coloradocube/eps/eps-eda/eps_bom/eps_BOM.xlsx

Sheet: eps_masterBOM
; | /Users/sethschisler/eps/eps-eda/master_schematic.kicad_sch
Date: | Monday, April 25, 2022 at 09:28:04 AM
Tool: | Eeschema (6.0.1-0)
Generator: | /Applications/KiCad/KiCad.app/Contents/SharedSupport/plugins/bom_csv_grouped_by_value_with_fp.py |  |  |  |  | DOES JLC CARRY? Y/N | Parts list: https://jlcpcb.com/parts/componentSearch
Component Count: | 80
Ref | Qnty | Value | Cmp name | Footprint | Description
C1, C2, C8, C10, C11, C12, | 6 | 10uF | C_Small | Capacitor_SMD:C_0603_1608Metric | Unpolarized capacitor, small symbol | Y
C3, | 1 | 0.1ŒºF | C_Small | Capacitor_SMD:C_0402_1005Metric | Unpolarized capacitor, small symbol | Y
C5, C6, C7, | 3 | 2.2uF | C_Small | Capacitor_SMD:C_0603_1608Metric | Unpolarized capacitor, small symbol | Y
C9, | 1 | 0.1uF | C_Small | Capacitor_SMD:C_0402_1005Metric | Unpolarized capacitor, small symbol | Y
C13, C20, | 2 | 22uF | C | Capacitor_SMD:C_0603_1608Metric | Unpolarized capacitor | Y
C14, C18, C19, C21, | 4 | 0.1uF | C | Capacitor_SMD:C_0603_1608Metric | Unpolarized capacitor | Y
C15, | 1 | 0.47uF | C_Small | Capacitor_SMD:C_0603_1608Metric | Unpolarized capacitor, small symbol | Y
C16, | 1 | 100nF | C | Capacitor_SMD:C_0603_1608Metric | Unpolarized capacitor | Y
C17, | 1 | 4.7nF | C | Capacitor_SMD:C_0603_1608Metric | Unpolarized capacitor | Y
Ca1, Ca2, Ca3, | 3 | 22uF | C2012X5R1A226M125AB | Capacitor_SMD:C_0805_2012Metric | Unpolarized capacitor, small symbol | Y
Cb1, Cb2, Cb3, | 3 | 22uF | C2012X5R1A226M125AB | Capacitor_SMD:C_0805_2012Metric | Unpolarized capacitor, small symbol | Y
D1, D2, | 2 | LED | LED | LED_SMD:LED_0603_1608Metric | Light emitting diode
D4, | 1 | PD3Z284C3V6-7 | PD3Z284C3V6-7 | zener_ovp:PD3Z284C3V6-7 |  | N
D5, | 1 | RED | LED_Small_Filled | LED_SMD:LED_0603_1608Metric | Light emitting diode, small symbol, filled shape
D6, | 1 | GREEN | LED_Small_Filled | LED_SMD:LED_0603_1608Metric | Light emitting diode, small symbol, filled shape
D7, D8, D9, | 3 | YELLOW | LED_Small_Filled | LED_SMD:LED_0603_1608Metric | Light emitting diode, small symbol, filled shape
D_3.3, | 1 | PD3S230LQ-7 | PD3S230LQ-7 | footprints3:PD3S230LQ-7 |  | N
Din1, | 1 | DIODE | DIODE | Diode_SMD:D_0805_2012Metric | Diode, anode on pin 1, for simulation only! | <---do we need this??
J1, | 1 | 12401610E4#2A | USB_C_Receptacle | Connector_USB:USB_C_Receptacle_Amphenol_12401610E4-2A | USB Full-Featured Type-C Receptacle connector | N
J2, | 1 | 436500212 | 436500212 | molex connector:436500212 |  | Y
J3, | 1 | 826632-2 | Conn_02x20_Odd_Even | Connector_PinHeader_2.54mm:PinHeader_2x20_P2.54mm_Vertical | Generic connector, double row, 02x20, odd/even pin numbering scheme (row 1 odd numbers, row 2 even numbers), script generated (kicad-library-utils/schlib/autogen/connector/) | N
J4, | 1 | PH1RB-05-UA | Conn_01x05_Female | Connector_PinHeader_2.54mm:PinHeader_1x05_P2.54mm_Horizontal | Generic connector, single row, 01x05, script generated (kicad-library-utils/schlib/autogen/connector/) | N
JP1, | 1 | SolderJumper_2_Open | SolderJumper_2_Open | Jumper:SolderJumper-2_P1.3mm_Bridged2Bar_Pad1.0x1.5mm | Solder Jumper, 2-pole, open | <---do we need this??
L1, | 1 | .47uH | CIGT252010LMR47MNE | Inductor_SMD:L_1008_2520Metric | Inductor, small symbol | N
L2, L3, | 2 | 744316100 | 744316100 | footprints1:744316100 |  | N
Q2, | 1 | FZT688BTA | 2N2219 | fzt688bta_footprint:SOT230P700X180-4N | 800mA Ic, 50V Vce, NPN Transistor, TO-39 | out of stock
R1, R2, | 2 | PSF4NTEBL500F | PSF4NTEBL500F | psf4nt:PSF4NTEBL500F |  | Y
R3, R4, R5, R6, R7, | 5 | 10kŒ© | R_Small_US | Resistor_SMD:R_0603_1608Metric | Resistor, small US symbol | Y
R8, R10, | 2 | 1k | R_Small_US | Resistor_SMD:R_0402_1005Metric | Resistor, small US symbol | Y
R9, | 1 | 24.9k | R_Small_US | Resistor_SMD:R_0402_1005Metric | Resistor, small US symbol | Y
R11, | 1 | 10k | R_Small_US | Resistor_SMD:R_0402_1005Metric | Resistor, small US symbol | Y
R12, | 1 | 0.01 | R_Small_US | Resistor_SMD:R_0805_2012Metric | Resistor, small US symbol
R13, R14, | 2 | 60 | R | Resistor_SMD:R_0603_1608Metric | Resistor | Y
R15, | 1 | 10k | R | Resistor_SMD:R_0603_1608Metric | Resistor | Y
R16, | 1 | 200 | R | Resistor_SMD:R_0603_1608Metric | Resistor | Y
R19, R20, R21, R22, R23, | 5 | 330 | R | Resistor_SMD:R_0603_1608Metric | Resistor | Y
R_3.3, | 1 | 1k | R_Small_US | Resistor_SMD:R_0603_1608Metric | Resistor, small US symbol | Y
Ra1, | 1 | 732K | RMCF0603FG732K | Resistor_SMD:R_0603_1608Metric | Resistor, small US symbol | N
Ra2, | 1 | 100k | KTR03EZPF1003 | Resistor_SMD:R_0603_1608Metric | Resistor, small US symbol | Y
Rb1, | 1 | 453k | RMCF0603FT453K | Resistor_SMD:R_0603_1608Metric | Resistor, small US symbol | N
Rb2, | 1 | 100k | KTR03EZPF1003 | Resistor_SMD:R_0603_1608Metric | Resistor, small US symbol | Y
Rpu1, | 1 | 10kŒ© | R_Small_US | Resistor_SMD:R_0603_1608Metric | Resistor, small US symbol | Y
TH1, | 1 | 10k | NTCS0603E3103HLT | Resistor_SMD:R_0603_1608Metric | Temperature dependent resistor, negative temperature coefficient | N
U1, U2, | 2 | TPS61022RWUR | TPS61022RWUR | footprints:TPS61022RWUR |  | N
U3, | 1 | INA3221AIRGVR | INA3221 | Package_DFN_QFN:Texas_RGV_S-PVQFN-N16_EP2.1x2.1mm | Triple-Channel High-Side Shunt and Bus Voltage Monitor with I2C and SMBUS Compatible Interface, QFN-16 | Y
U5, | 1 | MAX77757JEFG435+ | MAX77757JEFG435+ | max77757:IC_MAX77757JEFG435+ |  | N
U6, | 1 | MAX17055ETB+T | MAX17055ETB+T | max17055 smd:MAX17055ETB&plus_T |  | N
U7, | 1 | ATA6560-GAQW-VAO | ATA6560-GAQW-VAO | ata6560:ATA6560-GAQW-VAO |  | N
U8, | 1 | PIC18F27Q84-E/SP | PIC18F27Q84-E{slash}SP | pic18f27:PIC18F27Q84-E&slash_SP |  | N

Sheet: eps_masterBOM (2)
; | /Users/sethschisler/eps/eps-eda/master_schematic.kicad_sch
Date: | Monday, April 25, 2022 at 09:28:04 AM
Tool: | Eeschema (6.0.1-0)
Generator: | /Applications/KiCad/KiCad.app/Contents/SharedSupport/plugins/bom_csv_grouped_by_value_with_fp.py |  |  |  |  | DOES JLC CARRY? Y/N | Parts list: https://jlcpcb.com/parts/componentSearch
Component Count: | 80
Ref | Qnty | Value | Cmp name | Footprint | Description |  | Comment | Designator | Footprint | JLSPCB Part #
C1, C2, C8, C10, C11, C12, | 6 | 10uF | C_Small | Capacitor_SMD:C_0603_1608Metric | Unpolarized capacitor, small symbol | Y | 10uF, C_Small, Unpolarized capacitor, small symbol | C1, C2, C8, C10, C11, C12, | Capacitor_SMD:C_0603_1608Metric
C3, | 1 | 0.1uF | C_Small | Capacitor_SMD:C_0402_1005Metric | Unpolarized capacitor, small symbol | Y | 0.1uF, C_Small, Unpolarized capacitor, small symbol | C3, | Capacitor_SMD:C_0402_1005Metric
C5, C6, C7, | 3 | 2.2uF | C_Small | Capacitor_SMD:C_0603_1608Metric | Unpolarized capacitor, small symbol | Y | 2.2uF, C_Small, Unpolarized capacitor, small symbol | C5, C6, C7, | Capacitor_SMD:C_0603_1608Metric
C9, | 1 | 0.1uF | C_Small | Capacitor_SMD:C_0402_1005Metric | Unpolarized capacitor, small symbol | Y | 0.1uF, C_Small, Unpolarized capacitor, small symbol | C9, | Capacitor_SMD:C_0402_1005Metric
C13, C20, | 2 | 22uF | C | Capacitor_SMD:C_0603_1608Metric | Unpolarized capacitor | Y | 22uF, C, Unpolarized capacitor | C13, C20, | Capacitor_SMD:C_0603_1608Metric
C14, C18, C19, C21, | 4 | 0.1uF | C | Capacitor_SMD:C_0603_1608Metric | Unpolarized capacitor | Y | 0.1uF, C, Unpolarized capacitor | C14, C18, C19, C21, | Capacitor_SMD:C_0603_1608Metric
C15, | 1 | 0.47uF | C_Small | Capacitor_SMD:C_0603_1608Metric | Unpolarized capacitor, small symbol | Y | 0.47uF, C_Small, Unpolarized capacitor, small symbol | C15, | Capacitor_SMD:C_0603_1608Metric
C16, | 1 | 100nF | C | Capacitor_SMD:C_0603_1608Metric | Unpolarized capacitor | Y | 100nF, C, Unpolarized capacitor | C16, | Capacitor_SMD:C_0603_1608Metric
C17, | 1 | 4.7nF | C | Capacitor_SMD:C_0603_1608Metric | Unpolarized capacitor | Y | 4.7nF, C, Unpolarized capacitor | C17, | Capacitor_SMD:C_0603_1608Metric
Ca1, Ca2, Ca3, | 3 | 22uF | C2012X5R1A226M125AB | Capacitor_SMD:C_0805_2012Metric | Unpolarized capacitor, small symbol | Y | 22uF, C2012X5R1A226M125AB, Unpolarized capacitor, small symbol | Ca1, Ca2, Ca3, | Capacitor_SMD:C_0805_2012Metric
Cb1, Cb2, Cb3, | 3 | 22uF | C2012X5R1A226M125AB | Capacitor_SMD:C_0805_2012Metric | Unpolarized capacitor, small symbol | Y | 22uF, C2012X5R1A226M125AB, Unpolarized capacitor, small symbol | Cb1, Cb2, Cb3, | Capacitor_SMD:C_0805_2012Metric
D1, D2, | 2 | LED | LED | LED_SMD:LED_0603_1608Metric | Light emitting diode |  | LED, LED, Light emitting diode | D1, D2, | LED_SMD:LED_0603_1608Metric
D4, | 1 | PD3Z284C3V6-7 | PD3Z284C3V6-7 | zener_ovp:PD3Z284C3V6-7 |  | N | PD3Z284C3V6-7, PD3Z284C3V6-7, | D4, | zener_ovp:PD3Z284C3V6-7
D5, | 1 | RED | LED_Small_Filled | LED_SMD:LED_0603_1608Metric | Light emitting diode, small symbol, filled shape |  | RED, LED_Small_Filled, Light emitting diode, small symbol, filled shape | D5, | LED_SMD:LED_0603_1608Metric
D6, | 1 | GREEN | LED_Small_Filled | LED_SMD:LED_0603_1608Metric | Light emitting diode, small symbol, filled shape |  | GREEN, LED_Small_Filled, Light emitting diode, small symbol, filled shape | D6, | LED_SMD:LED_0603_1608Metric
D7, D8, D9, | 3 | YELLOW | LED_Small_Filled | LED_SMD:LED_0603_1608Metric | Light emitting diode, small symbol, filled shape |  | YELLOW, LED_Small_Filled, Light emitting diode, small symbol, filled shape | D7, D8, D9, | LED_SMD:LED_0603_1608Metric
D_3.3, | 1 | PD3S230LQ-7 | PD3S230LQ-7 | footprints3:PD3S230LQ-7 |  | N | PD3S230LQ-7, PD3S230LQ-7, | D_3.3, | footprints3:PD3S230LQ-7
Din1, | 1 | DIODE | DIODE | Diode_SMD:D_0805_2012Metric | Diode, anode on pin 1, for simulation only! | <---do we need this?? | DIODE, DIODE, Diode, anode on pin 1, for simulation only! | Din1, | Diode_SMD:D_0805_2012Metric
J1, | 1 | 12401610E4#2A | USB_C_Receptacle | Connector_USB:USB_C_Receptacle_Amphenol_12401610E4-2A | USB Full-Featured Type-C Receptacle connector | N | 12401610E4#2A, USB_C_Receptacle, USB Full-Featured Type-C Receptacle connector | J1, | Connector_USB:USB_C_Receptacle_Amphenol_12401610E4-2A
J2, | 1 | 436500212 | 436500212 | molex connector:436500212 |  | Y | 436500212, 436500212, | J2, | molex connector:436500212
J3, | 1 | 826632-2 | Conn_02x20_Odd_Even | Connector_PinHeader_2.54mm:PinHeader_2x20_P2.54mm_Vertical | Generic connector, double row, 02x20, odd/even pin numbering scheme (row 1 odd numbers, row 2 even numbers), script generated (kicad-library-utils/schlib/autogen/connector/) | N | 826632-2, Conn_02x20_Odd_Even, Generic connector, double row, 02x20, odd/even pin numbering scheme (row 1 odd numbers, row 2 even numbers), script generated (kicad-library-utils/schlib/autogen/connector/) | J3, | Connector_PinHeader_2.54mm:PinHeader_2x20_P2.54mm_Vertical
J4, | 1 | PH1RB-05-UA | Conn_01x05_Female | Connector_PinHeader_2.54mm:PinHeader_1x05_P2.54mm_Horizontal | Generic connector, single row, 01x05, script generated (kicad-library-utils/schlib/autogen/connector/) | N | PH1RB-05-UA, Conn_01x05_Female, Generic connector, single row, 01x05, script generated (kicad-library-utils/schlib/autogen/connector/) | J4, | Connector_PinHeader_2.54mm:PinHeader_1x05_P2.54mm_Horizontal
JP1, | 1 | SolderJumper_2_Open | SolderJumper_2_Open | Jumper:SolderJumper-2_P1.3mm_Bridged2Bar_Pad1.0x1.5mm | Solder Jumper, 2-pole, open | <---do we need this?? | SolderJumper_2_Open, SolderJumper_2_Open, Solder Jumper, 2-pole, open | JP1, | Jumper:SolderJumper-2_P1.3mm_Bridged2Bar_Pad1.0x1.5mm
L1, | 1 | .47uH | CIGT252010LMR47MNE | Inductor_SMD:L_1008_2520Metric | Inductor, small symbol | N | .47uH, CIGT252010LMR47MNE, Inductor, small symbol | L1, | Inductor_SMD:L_1008_2520Metric
L2, L3, | 2 | 744316100 | 744316100 | footprints1:744316100 |  | N | 744316100, 744316100, | L2, L3, | footprints1:744316100
Q2, | 1 | FZT688BTA | 2N2219 | fzt688bta_footprint:SOT230P700X180-4N | 800mA Ic, 50V Vce, NPN Transistor, TO-39 | out of stock | FZT688BTA, 2N2219, 800mA Ic, 50V Vce, NPN Transistor, TO-39 | Q2, | fzt688bta_footprint:SOT230P700X180-4N
R1, R2, | 2 | PSF4NTEBL500F | PSF4NTEBL500F | psf4nt:PSF4NTEBL500F |  | Y | PSF4NTEBL500F, PSF4NTEBL500F, | R1, R2, | psf4nt:PSF4NTEBL500F
R3, R4, R5, R6, R7, | 5 | 10k | R_Small_US | Resistor_SMD:R_0603_1608Metric | Resistor, small US symbol | Y | 10k, R_Small_US, Resistor, small US symbol | R3, R4, R5, R6, R7, | Resistor_SMD:R_0603_1608Metric
R8, R10, | 2 | 1k | R_Small_US | Resistor_SMD:R_0402_1005Metric | Resistor, small US symbol | Y | 1k, R_Small_US, Resistor, small US symbol | R8, R10, | Resistor_SMD:R_0402_1005Metric
R9, | 1 | 24.9k | R_Small_US | Resistor_SMD:R_0402_1005Metric | Resistor, small US symbol | Y | 24.9k, R_Small_US, Resistor, small US symbol | R9, | Resistor_SMD:R_0402_1005Metric
R11, | 1 | 10k | R_Small_US | Resistor_SMD:R_0402_1005Metric | Resistor, small US symbol | Y | 10k, R_Small_US, Resistor, small US symbol | R11, | Resistor_SMD:R_0402_1005Metric
R12, | 1 | 0.01 | R_Small_US | Resistor_SMD:R_0805_2012Metric | Resistor, small US symbol |  | 0.01, R_Small_US, Resistor, small US symbol | R12, | Resistor_SMD:R_0805_2012Metric
R13, R14, | 2 | 60 | R | Resistor_SMD:R_0603_1608Metric | Resistor | Y | 60, R, Resistor | R13, R14, | Resistor_SMD:R_0603_1608Metric
R15, | 1 | 10k | R | Resistor_SMD:R_0603_1608Metric | Resistor | Y | 10k, R, Resistor | R15, | Resistor_SMD:R_0603_1608Metric
R16, | 1 | 200 | R | Resistor_SMD:R_0603_1608Metric | Resistor | Y | 200, R, Resistor | R16, | Resistor_SMD:R_0603_1608Metric
R19, R20, R21, R22, R23, | 5 | 330 | R | Resistor_SMD:R_0603_1608Metric | Resistor | Y | 330, R, Resistor | R19, R20, R21, R22, R23, | Resistor_SMD:R_0603_1608Metric
R_3.3, | 1 | 1k | R_Small_US | Resistor_SMD:R_0603_1608Metric | Resistor, small US symbol | Y | 1k, R_Small_US, Resistor, small US symbol | R_3.3, | Resistor_SMD:R_0603_1608Metric
Ra1, | 1 | 732K | RMCF0603FG732K | Resistor_SMD:R_0603_1608Metric | Resistor, small US symbol | N | 732K, RMCF0603FG732K, Resistor, small US symbol | Ra1, | Resistor_SMD:R_0603_1608Metric
Ra2, | 1 | 100k | KTR03EZPF1003 | Resistor_SMD:R_0603_1608Metric | Resistor, small US symbol | Y | 100k, KTR03EZPF1003, Resistor, small US symbol | Ra2, | Resistor_SMD:R_0603_1608Metric
Rb1, | 1 | 453k | RMCF0603FT453K | Resistor_SMD:R_0603_1608Metric | Resistor, small US symbol | N | 453k, RMCF0603FT453K, Resistor, small US symbol | Rb1, | Resistor_SMD:R_0603_1608Metric
Rb2, | 1 | 100k | KTR03EZPF1003 | Resistor_SMD:R_0603_1608Metric | Resistor, small US symbol | Y | 100k, KTR03EZPF1003, Resistor, small US symbol | Rb2, | Resistor_SMD:R_0603_1608Metric
Rpu1, | 1 | 10k | R_Small_US | Resistor_SMD:R_0603_1608Metric | Resistor, small US symbol | Y | 10k, R_Small_US, Resistor, small US symbol | Rpu1, | Resistor_SMD:R_0603_1608Metric
TH1, | 1 | 10k | NTCS0603E3103HLT | Resistor_SMD:R_0603_1608Metric | Temperature dependent resistor, negative temperature coefficient | N | 10k, NTCS0603E3103HLT, Temperature dependent resistor, negative temperature coefficient | TH1, | Resistor_SMD:R_0603_1608Metric
U1, U2, | 2 | TPS61022RWUR | TPS61022RWUR | footprints:TPS61022RWUR |  | N | TPS61022RWUR, TPS61022RWUR, | U1, U2, | footprints:TPS61022RWUR
U3, | 1 | INA3221AIRGVR | INA3221 | Package_DFN_QFN:Texas_RGV_S-PVQFN-N16_EP2.1x2.1mm | Triple-Channel High-Side Shunt and Bus Voltage Monitor with I2C and SMBUS Compatible Interface, QFN-16 | Y | INA3221AIRGVR, INA3221, Triple-Channel High-Side Shunt and Bus Voltage Monitor with I2C and SMBUS Compatible Interface, QFN-16 | U3, | Package_DFN_QFN:Texas_RGV_S-PVQFN-N16_EP2.1x2.1mm
U5, | 1 | MAX77757JEFG435+ | MAX77757JEFG435+ | max77757:IC_MAX77757JEFG435+ |  | N | MAX77757JEFG435+, MAX77757JEFG435+, | U5, | max77757:IC_MAX77757JEFG435+
U6, | 1 | MAX17055ETB+T | MAX17055ETB+T | max17055 smd:MAX17055ETB&plus_T |  | N | MAX17055ETB+T, MAX17055ETB+T, | U6, | max17055 smd:MAX17055ETB&plus_T
U7, | 1 | ATA6560-GAQW-VAO | ATA6560-GAQW-VAO | ata6560:ATA6560-GAQW-VAO |  | N | ATA6560-GAQW-VAO, ATA6560-GAQW-VAO, | U7, | ata6560:ATA6560-GAQW-VAO
U8, | 1 | PIC18F27Q84-E/SP | PIC18F27Q84-E{slash}SP | pic18f27:PIC18F27Q84-E&slash_SP |  | N | PIC18F27Q84-E/SP, PIC18F27Q84-E{slash}SP, | U8, | pic18f27:PIC18F27Q84-E&slash_SP

Sheet: eps_BOM_JLCPCB_220513
Comment | Designator | Footprint | JLSPCB Part # | Notes
10uF, C_Small, Unpolarized capacitor, small symbol | C1, C2, C8, C10, C11, C12, | Capacitor_SMD:C_0603_1608Metric | C19702
0.1uF, C_Small, Unpolarized capacitor, small symbol | C3, | Capacitor_SMD:C_0402_1005Metric | C1525
2.2uF, C_Small, Unpolarized capacitor, small symbol | C5, C6, C7, | Capacitor_SMD:C_0603_1608Metric | C23630
0.1uF, C_Small, Unpolarized capacitor, small symbol | C9, | Capacitor_SMD:C_0402_1005Metric | C1525
22uF, C, Unpolarized capacitor | C13, C20, | Capacitor_SMD:C_0603_1608Metric | C59461
0.1uF, C, Unpolarized capacitor | C14, C18, C19, C21, | Capacitor_SMD:C_0603_1608Metric | C14663
0.47uF, C_Small, Unpolarized capacitor, small symbol | C15, | Capacitor_SMD:C_0603_1608Metric | C1623
100nF, C, Unpolarized capacitor | C16, | Capacitor_SMD:C_0603_1608Metric | C14663
4.7nF, C, Unpolarized capacitor | C17, | Capacitor_SMD:C_0603_1608Metric | C53987
22uF, C2012X5R1A226M125AB, Unpolarized capacitor, small symbol | Ca1, Ca2, Ca3, | Capacitor_SMD:C_0805_2012Metric |  | Order | Mouser | https://www.mouser.com/ProductDetail/TDK/C2012X5R1A226M125AB?qs=LcTL%2F5vFEzEl81ah%2FUQuuw%3D%3D
22uF, C2012X5R1A226M125AB, Unpolarized capacitor, small symbol | Cb1, Cb2, Cb3, | Capacitor_SMD:C_0805_2012Metric |  | Order | Mouser | https://www.mouser.com/ProductDetail/TDK/C2012X5R1A226M125AB?qs=LcTL%2F5vFEzEl81ah%2FUQuuw%3D%3D
LED, LED, Light emitting diode | D1, D2, | LED_SMD:LED_0603_1608Metric | C2286
PD3Z284C3V6-7, PD3Z284C3V6-7, | D4, | zener_ovp:PD3Z284C3V6-7 |  | Order | DigiKey | https://www.digikey.com/en/products/detail/diodes-incorporated/PD3Z284C3V6-7/1629585
RED, LED_Small_Filled, Light emitting diode, small symbol, filled shape | D5, | LED_SMD:LED_0603_1608Metric | C2286
GREEN, LED_Small_Filled, Light emitting diode, small symbol, filled shape | D6, | LED_SMD:LED_0603_1608Metric | C72043
YELLOW, LED_Small_Filled, Light emitting diode, small symbol, filled shape | D7, D8, D9, | LED_SMD:LED_0603_1608Metric | C72038
PD3S230LQ-7, PD3S230LQ-7, | D_3.3, | footprints3:PD3S230LQ-7 |  | Order | Mouser | https://www.mouser.com/ProductDetail/Diodes-Incorporated/PD3S230HQ-7?qs=gAfoL%252BRo%2FrJZ9ppNTG9EUw%3D%3D
DIODE, DIODE, Diode, anode on pin 1, for simulation only! | Din1, | Diode_SMD:D_0805_2012Metric |  | Remove?
12401610E4#2A, USB_C_Receptacle, USB Full-Featured Type-C Receptacle connector | J1, | Connector_USB:USB_C_Receptacle_Amphenol_12401610E4-2A |  | Order | DigiKey | https://www.digikey.com/en/products/detail/amphenol-commercial-products/12401610E4%232A/5775520
436500212, 436500212, | J2, | molex connector:436500212 | C240839
826632-2, Conn_02x20_Odd_Even, Generic connector, double row, 02x20, odd/even pin numbering scheme (row 1 odd numbers, row 2 even numbers), script generated (kicad-library-utils/schlib/autogen/connector/) | J3, | Connector_PinHeader_2.54mm:PinHeader_2x20_P2.54mm_Vertical |  | Order | DigiKey | https://www.digikey.com/en/products/detail/te-connectivity-amp-connectors/826632-2/2276129
PH1RB-05-UA, Conn_01x05_Female, Generic connector, single row, 01x05, script generated (kicad-library-utils/schlib/autogen/connector/) | J4, | Connector_PinHeader_2.54mm:PinHeader_1x05_P2.54mm_Horizontal |  | Order | DigiKey | https://www.digikey.com/en/products/detail/adam-tech/PH1RB-06-UA/9830592
SolderJumper_2_Open, SolderJumper_2_Open, Solder Jumper, 2-pole, open | JP1, | Jumper:SolderJumper-2_P1.3mm_Bridged2Bar_Pad1.0x1.5mm |  | Remove
.47uH, CIGT252010LMR47MNE, Inductor, small symbol | L1, | Inductor_SMD:L_1008_2520Metric |  | Order | DigiKey | https://www.digikey.com/en/products/detail/samsung-electro-mechanics/CIGT252010LMR47MNE/7041266
744316100, 744316100, | L2, L3, | footprints1:744316100 |  | Order | Mouser | https://www.mouser.com/ProductDetail/Wurth-Elektronik/744316100?qs=%252B7BPNfeNhvUGKrgWBoCWwA%3D%3D
FZT688BTA, 2N2219, 800mA Ic, 50V Vce, NPN Transistor, TO-39 | Q2, | fzt688bta_footprint:SOT230P700X180-4N | C460087 | Order | Mouser | https://www.mouser.com/ProductDetail/Diodes-Incorporated/FZT688BTA?qs=Fd5IDHV0WqxCjVtHKYqUuw%3D%3D
PSF4NTEBL500F, PSF4NTEBL500F, | R1, R2, | psf4nt:PSF4NTEBL500F |  | Order | DigiKey | https://www.digikey.com/en/products/detail/koa-speer-electronics-inc/PSF4NTEBL500F/12728476
10k, R_Small_US, Resistor, small US symbol | R3, R4, R5, R6, R7, | Resistor_SMD:R_0603_1608Metric | C25804
1k, R_Small_US, Resistor, small US symbol | R8, R10, | Resistor_SMD:R_0402_1005Metric | C11702
24.9k, R_Small_US, Resistor, small US symbol | R9, | Resistor_SMD:R_0402_1005Metric | C25874
10k, R_Small_US, Resistor, small US symbol | R11, | Resistor_SMD:R_0402_1005Metric | C25744
0.01, R_Small_US, Resistor, small US symbol | R12, | Resistor_SMD:R_0805_2012Metric | C728271 | 0.5W
60, R, Resistor | R13, R14, | Resistor_SMD:R_0603_1608Metric | C166918 | Surprisingly difficult to find
10k, R, Resistor | R15, | Resistor_SMD:R_0603_1608Metric | C25804
200, R, Resistor | R16, | Resistor_SMD:R_0603_1608Metric | C8218
330, R, Resistor | R19, R20, R21, R22, R23, | Resistor_SMD:R_0603_1608Metric | C23138
1k, R_Small_US, Resistor, small US symbol | R_3.3, | Resistor_SMD:R_0603_1608Metric | C22764
732K, RMCF0603FG732K, Resistor, small US symbol | Ra1, | Resistor_SMD:R_0603_1608Metric |  | Order | DigiKey | https://www.digikey.com/en/products/detail/stackpole-electronics-inc/RMCF0603FG732K/1714225
100k, KTR03EZPF1003, Resistor, small US symbol | Ra2, | Resistor_SMD:R_0603_1608Metric | C510119
453k, RMCF0603FT453K, Resistor, small US symbol | Rb1, | Resistor_SMD:R_0603_1608Metric | C2484682 | Order | DigiKey | https://www.digikey.com/en/products/detail/stackpole-electronics-inc/RMCF0603FT453K/1761122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
100k, KTR03EZPF1003, Resistor, small US symbol | Rb2, | Resistor_SMD:R_0603_1608Metric | C510119
10k, R_Small_US, Resistor, small US symbol | Rpu1, | Resistor_SMD:R_0603_1608Metric | C25804
10k, NTCS0603E3103HLT, Temperature dependent resistor, negative temperature coefficient | TH1, | Resistor_SMD:R_0603_1608Metric |  | Order | DigiKey | https://www.digikey.com/en/products/detail/vishay-beyschlag-draloric-bc-components/NTCS0603E3103HLT/2615422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
TPS61022RWUR, TPS61022RWUR, | U1, U2, | footprints:TPS61022RWUR |  | OUT OF STOCK GLOBALLY | Mouser | https://www.mouser.com/ProductDetail/Texas-Instruments/TPS61022RWUR?qs=vLWxofP3U2zlxrk4cD0iFA%3D%3D
INA3221AIRGVR, INA3221, Triple-Channel High-Side Shunt and Bus Voltage Monitor with I2C and SMBUS Compatible Interface, QFN-16 | U3, | Package_DFN_QFN:Texas_RGV_S-PVQFN-N16_EP2.1x2.1mm | C181255
MAX77757JEFG435+, MAX77757JEFG435+, | U5, | max77757:IC_MAX77757JEFG435+ |  | Order | DigiKey | https://www.digikey.com/en/products/detail/analog-devices-inc-maxim-integrated/MAX77757JEFG435/13978783
MAX17055ETB+T, MAX17055ETB+T, | U6, | max17055 smd:MAX17055ETB&plus_T | C402925 | OUT OF STOCK GLOBALLY | DigiKey | https://www.digikey.com/en/products/detail/maxim-integrated/MAX17055ETB-T/7200799
ATA6560-GAQW-VAO, ATA6560-GAQW-VAO, | U7, | ata6560:ATA6560-GAQW-VAO |  | On hand
PIC18F27Q84-E/SP, PIC18F27Q84-E{slash}SP, | U8, | pic18f27:PIC18F27Q84-E&slash_SP |  | On hand
