coloradocube/eps/eps-drawings/PDB_BlockDiagram_Rev-C.pdf

## Signal Power

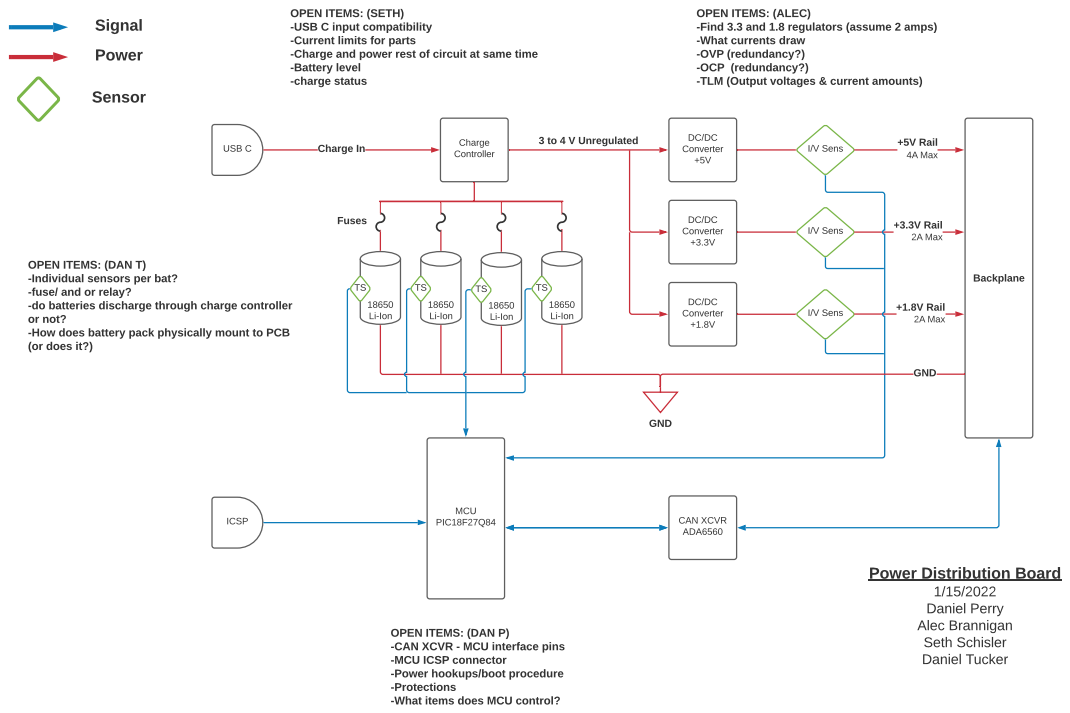
[picture p1: page 1]
Charge Controller; DC/DC Converter +5V; 3 to 4 V Unregulated; Backplane; MCU PIC18F27Q84; I/V Sens; +5V Rail 4A Max; USB C; Charge In; 18650 Li-Ion; CAN XCVR ADA6560; DC/DC Converter +3.3V; DC/DC Converter +1.8V; +3.3V Rail 2A Max; +1.8V Rail 2A Max; GND; Sensor; Fuses; 1/15/2022 Daniel Perry Alec Brannigan Seth Schisler Daniel Tucker; ICSP

OPEN ITEMS: (SETH)
-USB C input compatibility
-Current limits for parts
-Charge and power rest of circuit at same time
-Battery level
-charge status

OPEN ITEMS: (ALEC)
-Find 3.3 and 1.8 regulators (assume 2 amps)
-What currents draw
-OVP (redundancy?)
-OCP (redundancy?)
-TLM (Output voltages & current amounts)

OPEN ITEMS: (DAN T)
-Individual sensors per bat?
-fuse/ and or relay?
-do batteries discharge through charge controller
or not?
-How does battery pack physically mount to PCB
(or does it?)

Power Distribution Board

OPEN ITEMS: (DAN P)
-CAN XCVR - MCU interface pins
-MCU ICSP connector
-Power hookups/boot procedure
-Protections
-What items does MCU control?
