coloradocube/eps/eps-eda/master_schematic.kicad_pcb

## KiCad design eps-eda/master_schematic.kicad_pcb (2022-04-25)

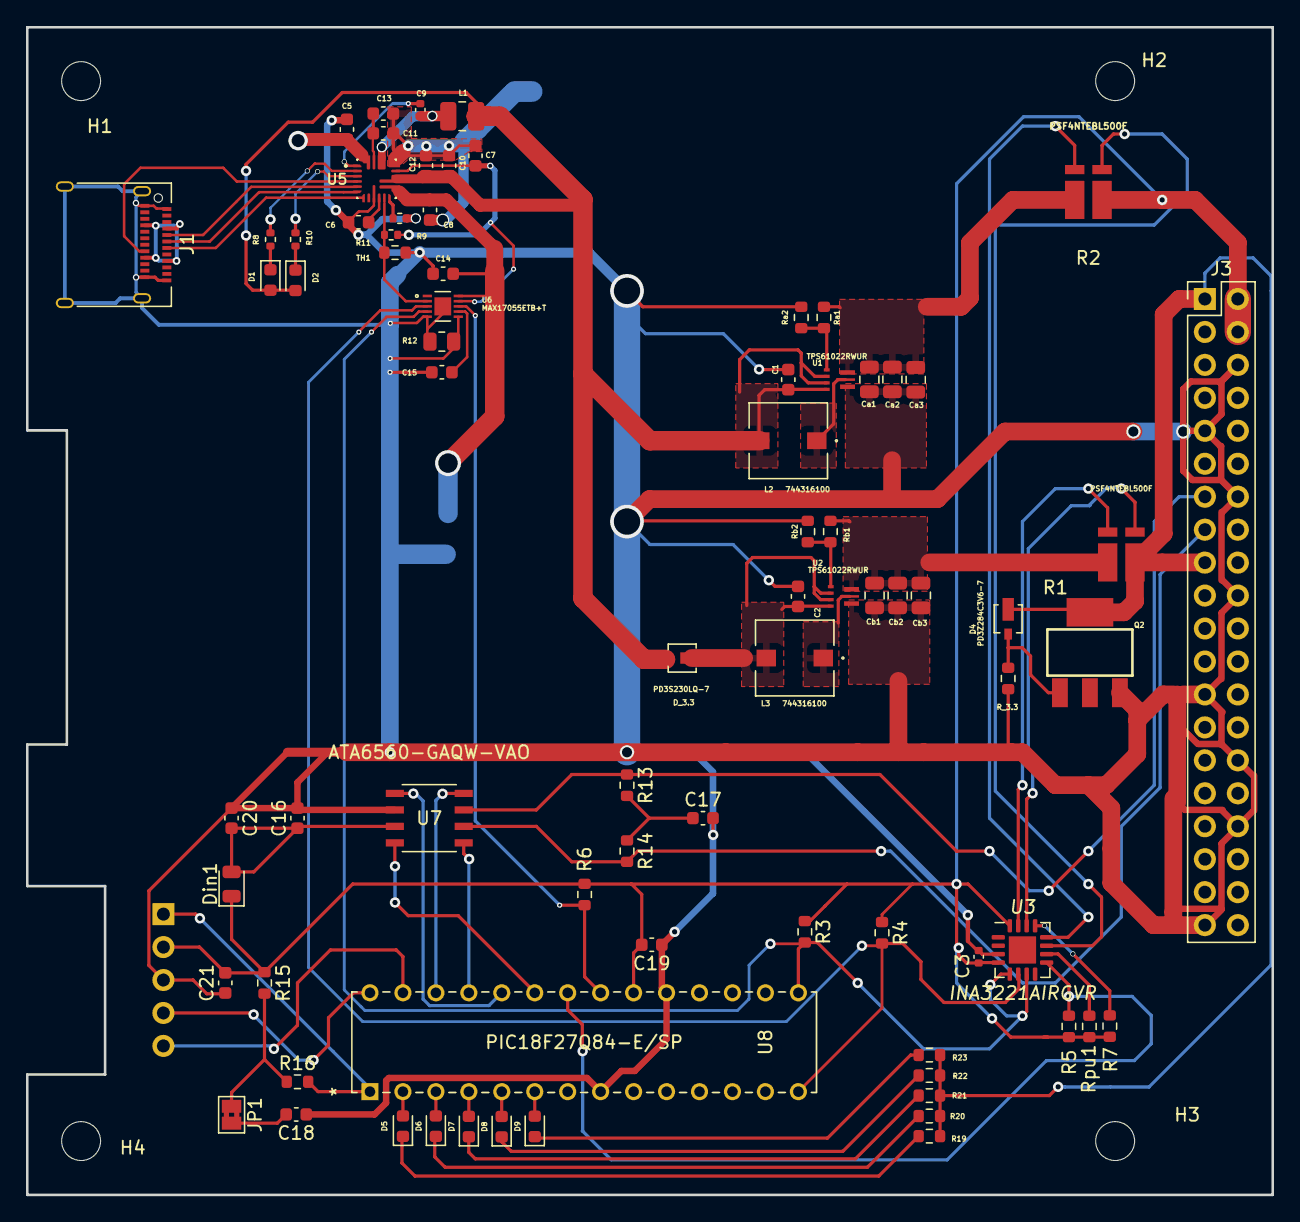
[picture p2: board master_schematic.kicad_pcb from above]

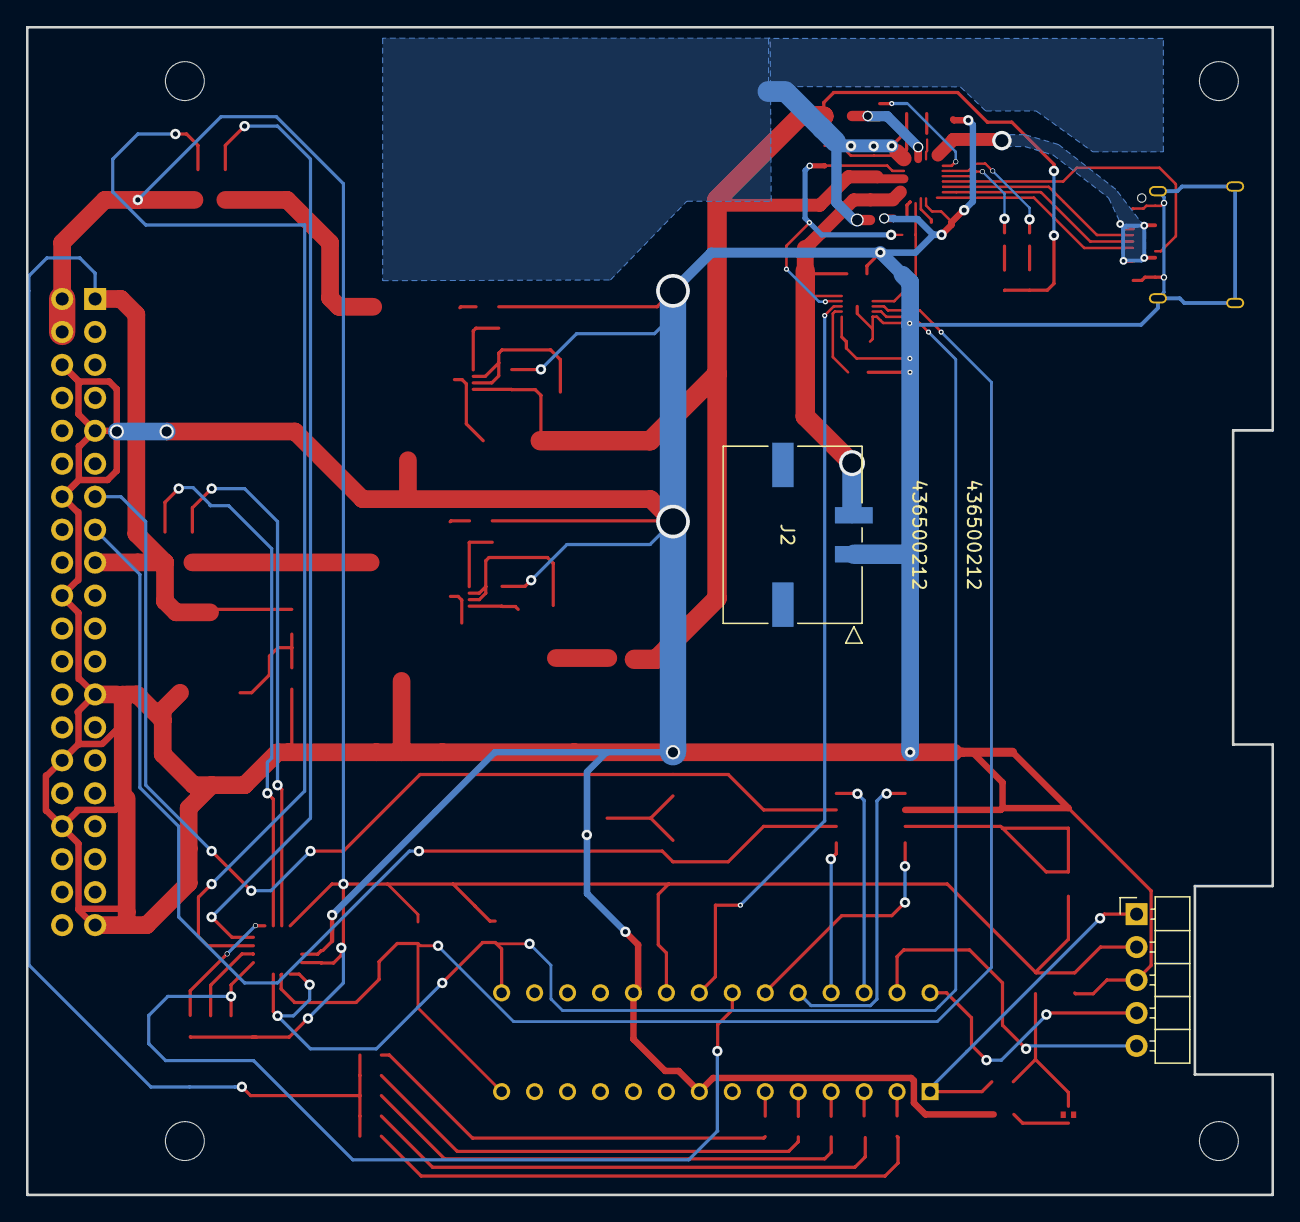
[picture p3: board master_schematic.kicad_pcb from below]

Board: 2 copper layers, 96.0 x 90.0 mm, 84 parts (2 on the bottom side), 64 nets.

Parts:
C1, C2, C8, C10, C11, C12: 10uF; C_0603_1608Metric
C3: 0.1μF; C_0402_1005Metric
C5, C6, C7: 2.2uF; C_0603_1608Metric
C9: 0.1uF; C_0402_1005Metric
C13, C20: 22uF; C_0603_1608Metric
C14, C18, C19, C21: 0.1uF; C_0603_1608Metric
C15: 0.47uF; C_0603_1608Metric
C16: 100nF; C_0603_1608Metric
C17: 4.7nF; C_0603_1608Metric
Ca1, Ca2, Ca3: 22uF; C_0805_2012Metric
Cb1, Cb2, Cb3: 22uF; C_0805_2012Metric
D1, D2: LED; LED_0603_1608Metric
D4: PD3Z284C3V6-7
D5: RED; LED_0603_1608Metric
D6: GREEN; LED_0603_1608Metric
D7, D8, D9: YELLOW; LED_0603_1608Metric
D_3.3: PD3S230LQ-7
Din1: DIODE; D_0805_2012Metric
H1, H2, H3, H4: 3mm_Mounting_Hole; MountingHole_3mm
J1: USB_C_Receptacle; USB_C_Receptacle_Amphenol_12401610E4-2A
J2: 436500212
J3: Conn_02x20_Odd_Even; PinHeader_2x20_P2.54mm_Vertical
J4: Conn_01x05_90deg; PinHeader_1x05_P2.54mm_Horizontal
JP1: SolderJumper_2_Open; SolderJumper-2_P1.3mm_Bridged2Bar_Pad1.0x1.5mm
L1: .47uH; L_1008_2520Metric
L2, L3: 744316100
Q2: FZT688BTA; SOT230P700X180-4N
R1, R2: PSF4NTEBL500F
R3, R4, R5, R6, R7: 10kΩ; R_0603_1608Metric
R8, R10: 1k; R_0402_1005Metric
R9: 24.9k; R_0402_1005Metric
R11: 10k; R_0402_1005Metric
R12: 0.010; R_0805_2012Metric
R13, R14: 60; R_0603_1608Metric
R15: 10k; R_0603_1608Metric
R16: 200; R_0603_1608Metric
R19, R20, R21, R22, R23: 330; R_0603_1608Metric
R_3.3: 1k; R_0603_1608Metric
Ra1: 732K; R_0603_1608Metric
Ra2: 100k; R_0603_1608Metric
Rb1: 453k; R_0603_1608Metric
Rb2: 100k; R_0603_1608Metric
Rpu1: 10kΩ; R_0603_1608Metric
TH1: 10k; R_0603_1608Metric
U1, U2: TPS61022RWUR
U3: INA3221AIRGVR; Texas_RGV_S-PVQFN-N16_EP2.1x2.1mm
U5: MAX77757JEFG435+; IC_MAX77757JEFG435+
U6: MAX17055ETB+T; MAX17055ETB&plus_T
U7: ATA6560-GAQW-VAO
U8: PIC18F27Q84-E/SP; PIC18F27Q84-E&slash_SP

Connections:
/ColoradoCUBE_Payload/3.3V: D4.1, J3.1, J3.17, Q2.4 (C), R1.4, R19.2, R20.2, R21.2, R22.2, R23.2
/ColoradoCUBE_Payload/5V: C3.1, C19.2, C21.2, Din1.1 (A), J3.2, J3.4, J4.2, R2.4, R3.1, R4.1, R5.1, R6.1, R7.1, R15.1, Rpu1.1, U3.4 (VS), U3.16 (VPU), U8.20 (VDD)
/ColoradoCUBE_Payload/ALRT: R6.2, U6.8 (ALRT), U8.21 (RB0)
/ColoradoCUBE_Payload/CANH: J3.13, R13.1, U7.7 (CANH)
/ColoradoCUBE_Payload/CANL: J3.15, R14.2, U7.6 (CANL)
/ColoradoCUBE_Payload/CAN_Transceiver/CAN_RX: U7.4 (RXD), U8.23 (RB2)
/ColoradoCUBE_Payload/CAN_Transceiver/CAN_TX: U7.1 (TXD), U8.24 (RB3)
/ColoradoCUBE_Payload/CAN_Transceiver/NSIL: U7.5 (NSIL), U8.25 (RB4)
/ColoradoCUBE_Payload/CAN_Transceiver/PWR: C16.1, C20.2, Din1.2 (K), U7.3 (VCC)
/ColoradoCUBE_Payload/CAN_Transceiver/STBY: U7.8 (STBY), U8.26 (RB5)
/ColoradoCUBE_Payload/CRT: R5.2, U3.9 (CRITICAL), U8.22 (RB1)
/ColoradoCUBE_Payload/ICSPC: J4.5, U8.27 (RB6/ICSPCLK)
/ColoradoCUBE_Payload/ICSPD: J4.4, U8.28 (RB7/ICSPDAT)
/ColoradoCUBE_Payload/LED_1: D5.2 (A), U8.2 (RA0)
/ColoradoCUBE_Payload/LED_2: D6.2 (A), U8.3 (RA1)
/ColoradoCUBE_Payload/LED_3: D7.2 (A), U8.4 (RA2)
/ColoradoCUBE_Payload/LED_4: D8.2 (A), U8.5 (RA3)
/ColoradoCUBE_Payload/LED_5: D9.2 (A), U8.6 (RA4)
/ColoradoCUBE_Payload/MCLR: J4.1, R16.2, U8.1 (*MCLR/VPP/RE3)
/ColoradoCUBE_Payload/SCL_RC3: R4.2, U3.6 (SCL), U6.3 (SCL), U8.14 (RC3)
/ColoradoCUBE_Payload/SDA_RC4: R3.2, U3.5 (A0), U3.7 (SDA), U6.4 (SDA), U8.15 (RC4)
/charge schem/SYSPOWER: C1.1, C10.1, C12.1, D1.2 (A), D2.2 (A), D_3.3.2 (EPAD), L1.2, L2.2, U1.5 (EN), U1.6 (MODE), U1.7 (VIN), U5.15_16 (SYS)
/charge schem/V_BAT: C8.1, C14.1, J2.2, U5.13_14 (BATT), U6.10 (BATT)
/converterschematic/PV: Rpu1.2, U3.10 (PV)
/converterschematic/TC: R7.2, U3.13 (TC)
GND: C1.2, C2.2, C3.2, C5.2, C6.2, C14.2, C15.2, C16.2, C17.2, C18.1, C19.1, C20.1, C21.1, Ca1.2, Ca2.2, Ca3.2, Cb1.2, Cb2.2, Cb3.2, J1.A1 (GND), J1.A12 (GND), J1.B1 (GND), J1.B12 (GND), J1.S1 (SHIELD), J2.1, J3.6, J3.9, J3.14, J3.20, J3.25, J3.30, J3.34, J3.39, J4.3, Q2.3 (E), R9.2, R12.1, R12.2, R_3.3.2, Ra2.2, Rb2.2, TH1.2, U1.1 (GND), U2.1 (GND), U3.3 (GND), U5.9 (GND), U6.5 (CSN), U6.6 (CSP), U6.11 (EPAD), U7.2 (GND), U8.8 (VSS), U8.19 (VSS)
GNDPWR: C7.2, C8.2, C10.2, C11.2, C12.2, C13.2, U5.18_19 (PGND)
unnamed: C5.1, J1.A4 (VBUS), J1.A9 (VBUS), J1.B4 (VBUS), J1.B9 (VBUS), U5.23_24 (CHGIN)
unnamed: C6.1, U5.10 (VDD)
unnamed: C7.1, R11.1, U5.17 (PVL), U6.9 (THRM)
unnamed: C9.1, U5.1 (BST)
unnamed: C9.2, L1.1, U5.20_21 (LX)
unnamed: C11.1, C13.1, U5.22 (BYP)
unnamed: C15.1, U6.7 (REG)
unnamed: C17.1, R13.2, R14.1
unnamed: C18.2, JP1.2 (B)
unnamed: Ca1.1, Ca2.1, Ca3.1, R2.1, Ra1.1, U1.3 (VOUT)
unnamed: Cb1.1, Cb2.1, Cb3.1, R1.1, Rb1.1, U2.3 (VOUT)
unnamed: D1.1 (K), R8.1
unnamed: D2.1 (K), R10.1
unnamed: D4.2, Q2.1 (B), R_3.3.1
unnamed: D5.1 (K), R19.1
unnamed: D6.1 (K), R20.1
unnamed: D7.1 (K), R21.1
unnamed: D8.1 (K), R22.1
unnamed: D9.1 (K), R23.1
unnamed: C2.1, D_3.3.1 (EPAD), L3.2, U2.5 (EN), U2.6 (MODE), U2.7 (VIN)
unnamed: J1.A5 (CC1), U5.5 (CC1)
unnamed: J1.A6 (D+), U5.6 (DP)
unnamed: J1.A7 (D-), U5.7 (DN)
unnamed: J1.B5 (CC2), U5.4 (CC2)
unnamed: JP1.1 (A), R15.2, R16.1
unnamed: L2.1, U1.2 (SW)
unnamed: L3.1, U2.2 (SW)
unnamed: R1.2, U3.15 (IN+2)
unnamed: R1.3, U3.14 (IN-2)
unnamed: R2.2, U3.12 (IN+1)
unnamed: R2.3, U3.11 (IN-1)
unnamed: R8.2, U5.2 (INOKB)
unnamed: R9.1, U5.12 (IFAST)
unnamed: R10.2, U5.3 (STAT)
unnamed: R11.2, TH1.1, U5.11 (THM), U6.2 (AIN)
unnamed: Ra1.2, Ra2.1, U1.4 (FB)
unnamed: Rb1.2, Rb2.1, U2.4 (FB)
