coloradocube/eps/(commit log)

2022-04-21 first separate eps commit
    [CAN_Transceiver.kicad_sch, ColoradoCUBE_Payload.kicad_sch, DEBUG_INTERFACE.kicad_sch, Interboard_connector.kicad_sch, MCU_CAN.kicad_sch, OVP.kicad_sch, charge schem.kicad_sch, converterschematic.kicad_sch]
2022-04-22 rev 0.2 update
    added 90deg pic adapter to include an edge cutout.
    changed footprint of fuel gauge to implement ALRT signal.
    rotated battery connector to better implement with the battery board.
    [DEBUG_INTERFACE.kicad_sch, charge schem.kicad_sch, converterschematic.kicad_sch, master_schematic.kicad_pcb, master_schematic.kicad_sch]
2022-04-22 purged unnecessary files
    [eps_board.kicad_pcb, pcb_template.kicad_pcb]
2022-04-23 EPS V0.2
    Adjusted placement of resistors R19 through R23, and capacitor C18. For mounting purposes. Most DRC errors have now been cleared.
    [converterschematic.kicad_sch, master_schematic.kicad_pcb, master_schematic.kicad_sch]
2022-04-23 EPS V0.2 quick update
    added schottyky diode before 3.3V boost converter
    [converterschematic.kicad_sch, master_schematic.kicad_pcb, master_schematic.kicad_sch]
2022-04-23 EPS V0.3
    Added over voltage protection system for the 3.3V rail.
    [converterschematic.kicad_sch, master_schematic.kicad_pcb, master_schematic.kicad_sch, untitled.kicad_sch]
2022-04-25 rev 0.2
    ran DRC with updated board. rev0.2 complete
    [master_schematic.kicad_pcb]
2022-04-25 EPS BOM
    [EPS_masterBOM.xlsx]
2022-04-28 bom directory
2022-05-04 minor bom touchup
    [eps_BOM.xlsx]
2022-05-04 eps gerbers for jlcpcb
    [master_schematic-B_Cu.gbl, master_schematic-B_Mask.gbs, master_schematic-B_Paste.gbp, master_schematic-B_Silkscreen.gbo, master_schematic-Edge_Cuts.gm1, master_schematic-F_Cu.gtl, master_schematic-F_Mask.gts, master_schematic-F_Paste.gtp]
2022-05-10 student BOM minor edits
    [eps_BOM.xlsx]
2022-05-13 convert to JLC BOM format
    [eps_BOM.xlsx]
2022-05-13 JLC part number or order source
    [eps_BOM.xlsx]
2022-05-13 BOM as of 2022-05-13
    [eps_BOM.xlsx]
2022-05-13 Saving BOM for education
    Sample-BOM_JLCSMT contains the JLCPCB format. eps-bom-kicad-6-default is the default BOM export for the eps by KiCAD 6.0.2. eps_BOM contains 2 drafts and a finished sheet of the JLC-formatted BOM, with part numbers for the existing parts, sources for ordering the in-stock parts, and notes on globally out-of-stock parts.
    [Sample-BOM_JLCSMT.xlsx, eps-bom-kicad-6-default.xlsx, eps_BOM.xlsx, master_schematic-kicad-6-default.csv]
2022-05-13 Links to the out-of-stock parts
    [eps_BOM.xlsx]
